JourneyXuu/mitsuko-2024E/Project.ioc

Mcu.UserName=STM32F407VETx
PA10.Signal=USART1_RX
PA13.Signal=SYS_JTMS-SWDIO
PA14.Signal=SYS_JTCK-SWCLK
PA2.Signal=USART2_TX
PA3.Signal=USART2_RX
PA9.Signal=USART1_TX
PC13-ANTI_TAMP.GPIO_Label=Beep
PC13-ANTI_TAMP.Signal=GPIO_Output
PC6.Signal=USART6_TX
PC7.Signal=USART6_RX
PD13.GPIO_Label=LED_1
PD13.Signal=GPIO_Output
PD14.GPIO_Label=LED_2
PD14.Signal=GPIO_Output
PD15.GPIO_Label=LED_3
PD15.Signal=GPIO_Output
PD8.Signal=USART3_TX
PD9.Signal=USART3_RX
PE11.GPIO_Label=Magnet
PE11.Signal=GPIO_Output
PE9.Signal=S_TIM1_CH1
PH0-OSC_IN.Signal=RCC_OSC_IN
PH1-OSC_OUT.Signal=RCC_OSC_OUT
